haondt/Sailfish/pictures/20151111_104028.jpg

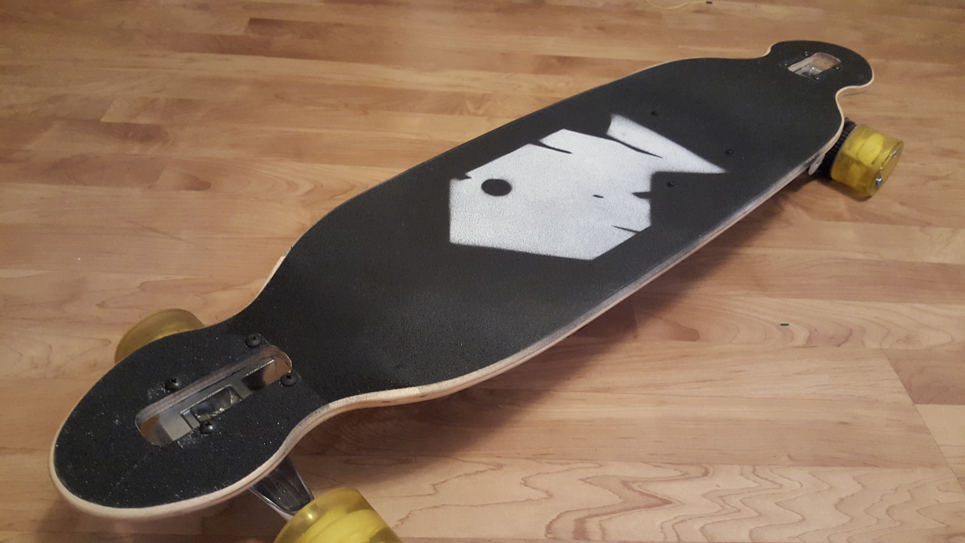
pictures/20151111_104028.jpg
