haondt/Sailfish/pictures/IMG_20160110_111257.jpg

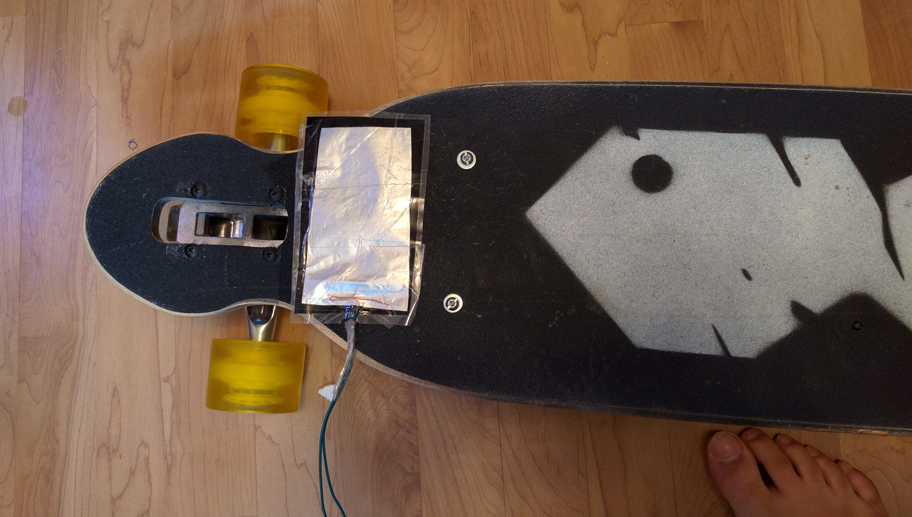
pictures/IMG_20160110_111257.jpg
