haondt/Sailfish/README.md

# Sailfish
A homemade electric longboard
https://www.youtube.com/watch?v=s4fFQhHfHzQ
Written in C/C++ for the Arduino.
Goes with accompanying code for the remote.
