haondt/Sailfish/pictures/20151111_104035.jpg

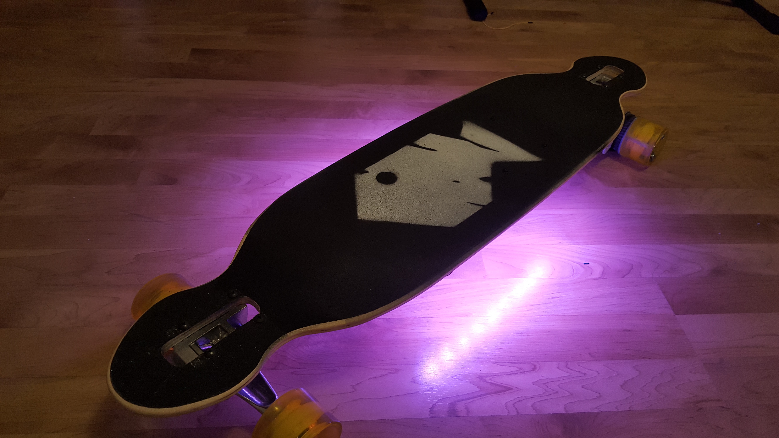
pictures/20151111_104035.jpg
