haondt/Sailfish/pictures/IMG_20160110_111248.jpg

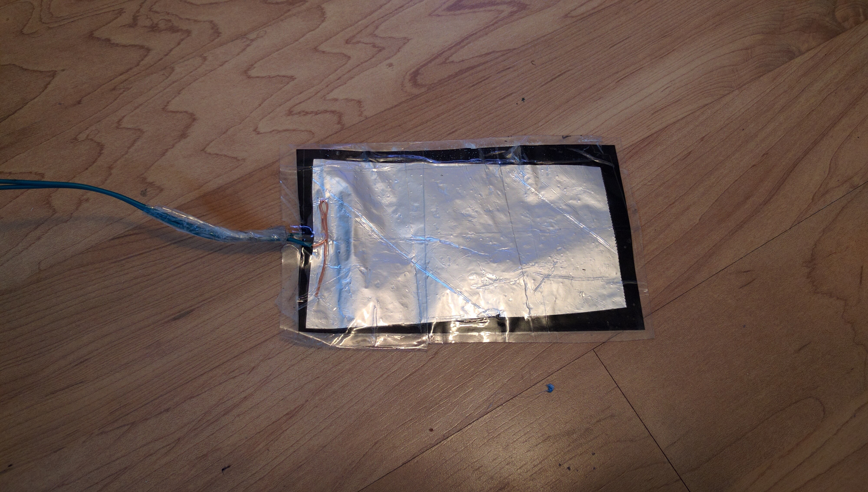
pictures/IMG_20160110_111248.jpg
