haondt/Sailfish/3d models/2.stl

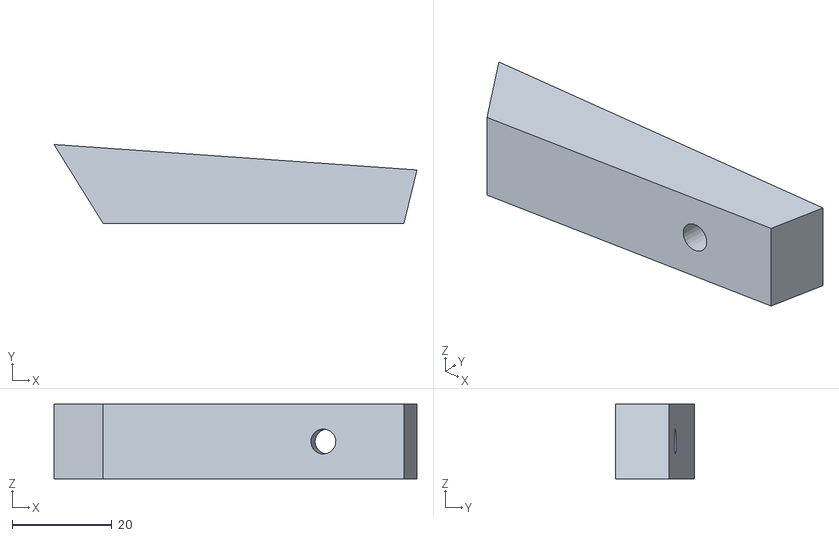
[picture p10: CAD file, 2018-02-10]
3d models/2.stl
72.8 x 15.9 x 15.0
