haondt/Sailfish/3d models/triangle.stl

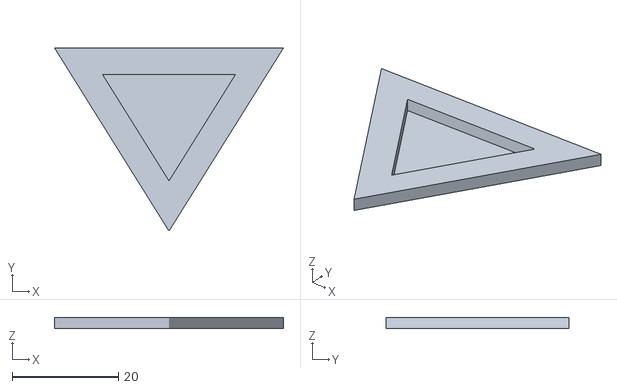
[picture p11: CAD file, 2018-02-10]
3d models/triangle.stl
43.0 x 34.4 x 2.00
