haondt/Sailfish/3d models/other models/zip tie spacer v1.stl

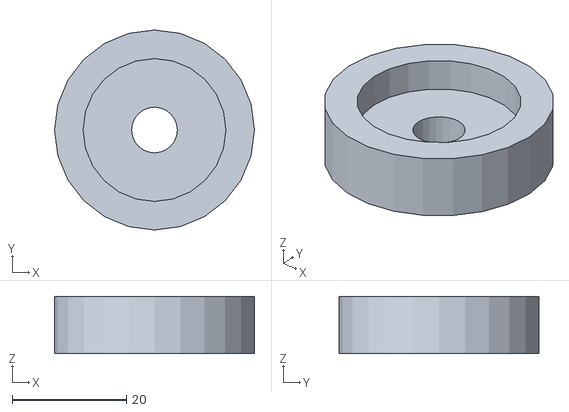
[picture p12: CAD file, 2018-02-10]
3d models/other models/zip tie spacer v1.stl
35.0 x 35.0 x 10.0
