haondt/Sailfish/3d models/other models/motor spacer v3.stl

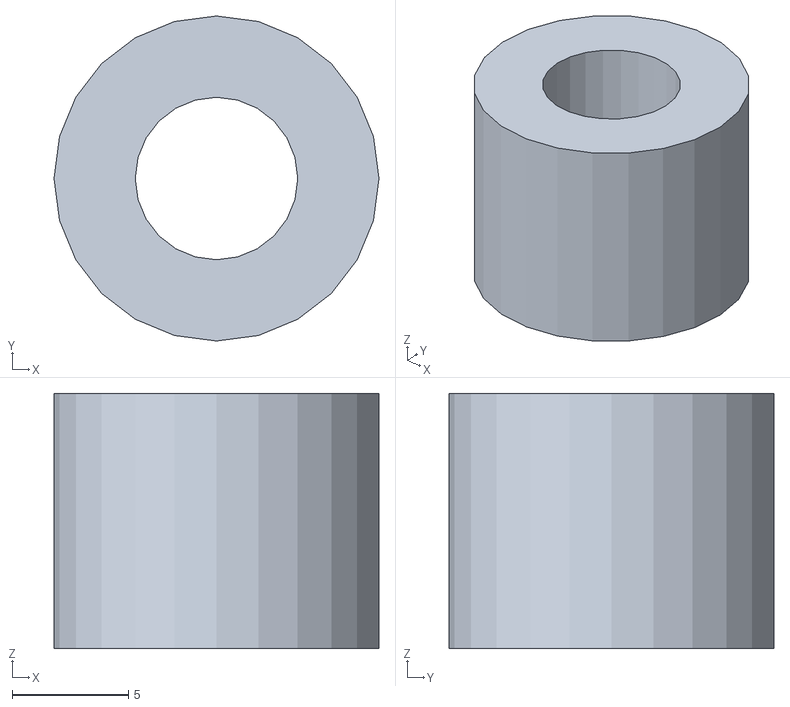
[picture p13: CAD file, 2018-02-10]
3d models/other models/motor spacer v3.stl
14.0 x 14.0 x 11.0
