haondt/Sailfish/3d models/other models/motor mount v7.stl

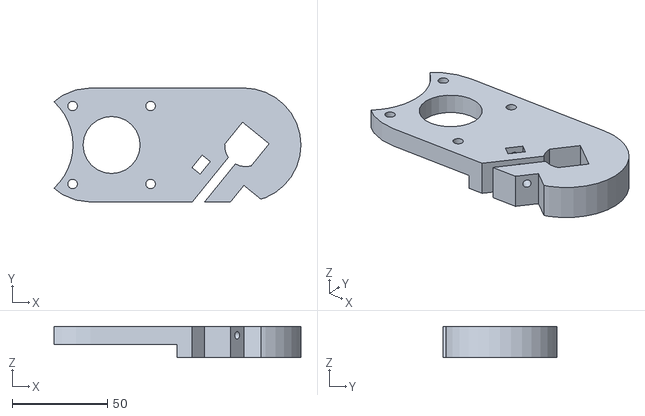
[picture p14: CAD file, 2018-02-10]
3d models/other models/motor mount v7.stl
129.9 x 60.0 x 16.5
