haondt/Sailfish/3d models/4.stl

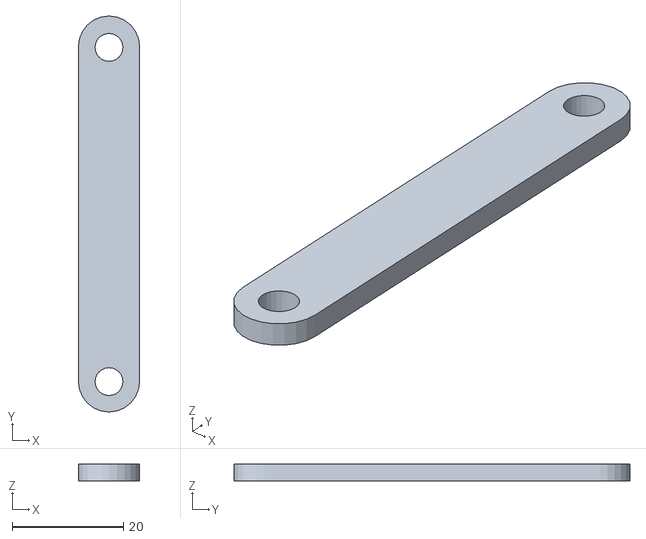
[picture p15: CAD file, 2018-02-10]
3d models/4.stl
11.0 x 71.1 x 3.00
