haondt/Sailfish/3d models/other models/motor spacer.stl

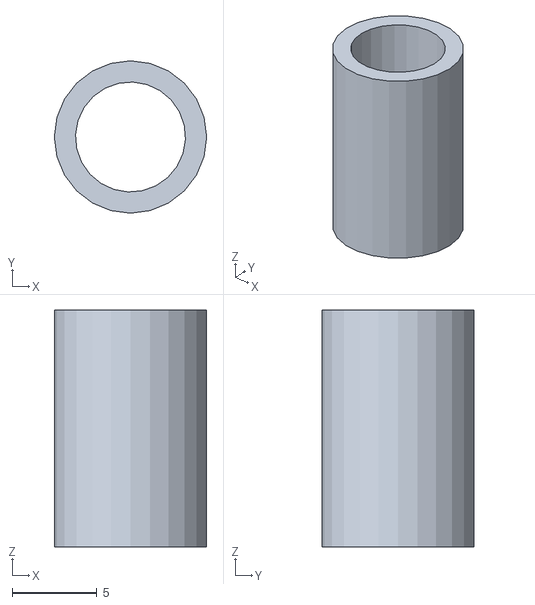
[picture p16: CAD file, 2018-02-10]
3d models/other models/motor spacer.stl
9.00 x 9.00 x 14.0
