haondt/Sailfish/3d models/thingc 2.stl

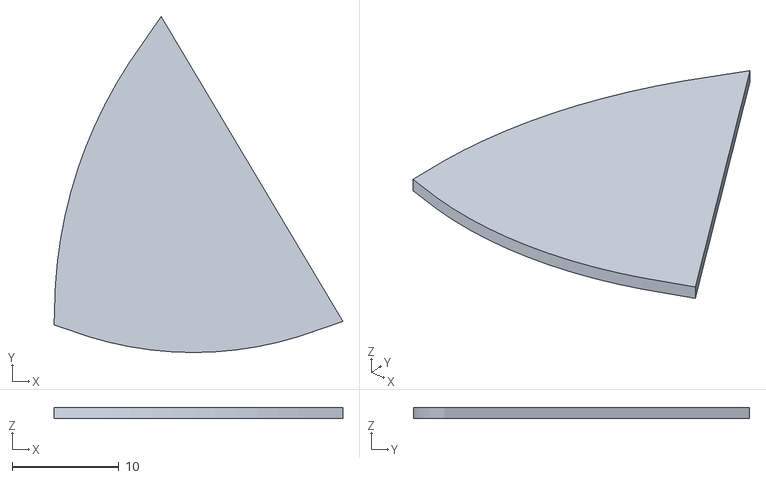
[picture p17: CAD file, 2018-02-10]
3d models/thingc 2.stl
27.0 x 31.4 x 1.00
