haondt/Sailfish/3d models/awkward motor mount.stl

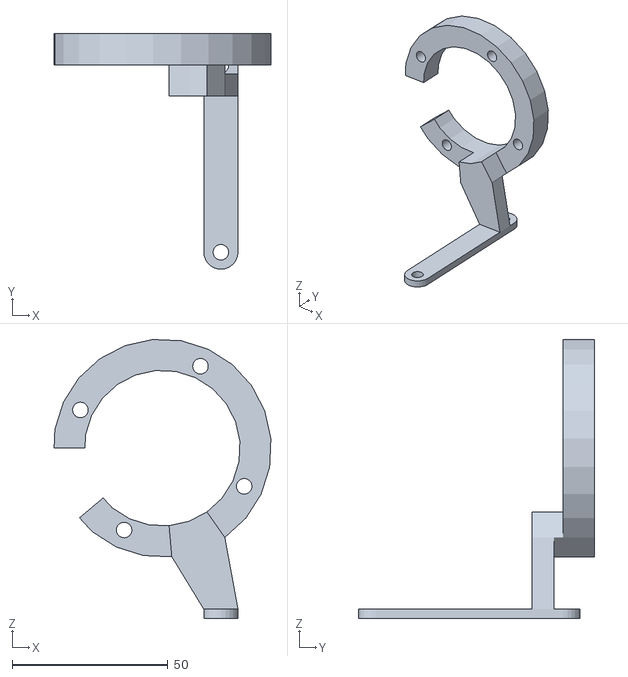
[picture p18: CAD file, 2018-02-10]
3d models/awkward motor mount.stl
69.6 x 75.6 x 89.5
