haondt/Sailfish/3d models/mototr mount v4.stl

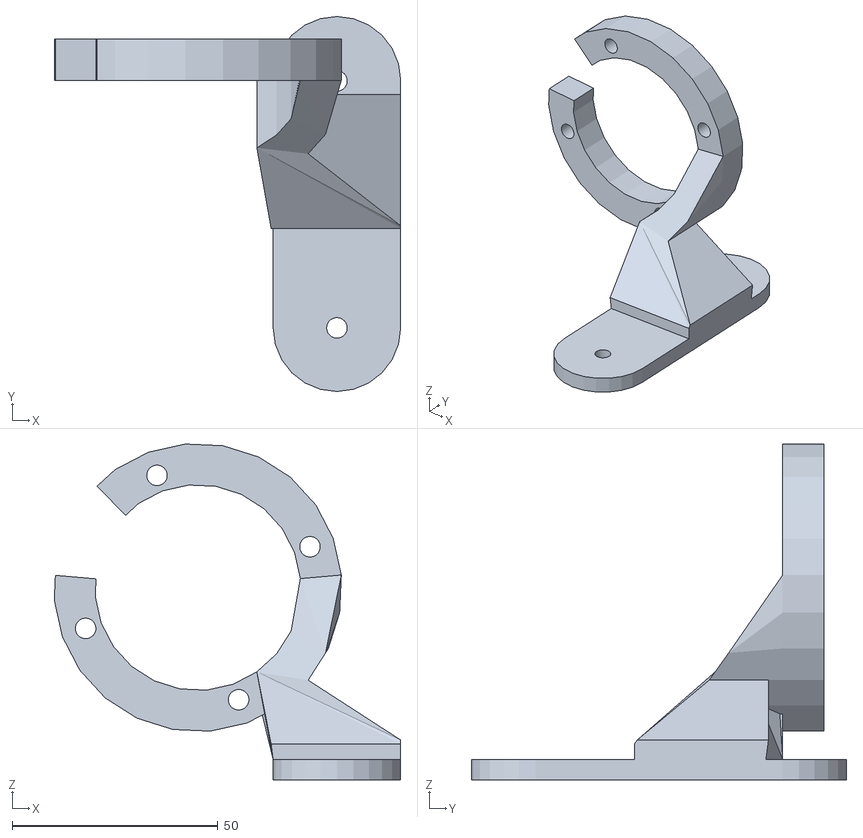
[picture p19: CAD file, 2018-02-10]
3d models/mototr mount v4.stl
84.2 x 91.1 x 81.6
