haondt/Sailfish/3d models/circle.stl

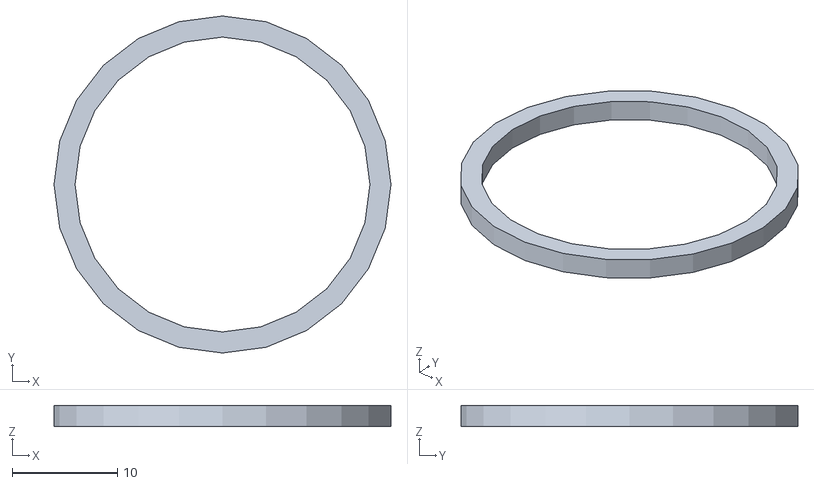
[picture p20: CAD file, 2018-02-10]
3d models/circle.stl
32.0 x 32.0 x 2.00
