haondt/Sailfish/3d models/motor mount v13_fixed.stl

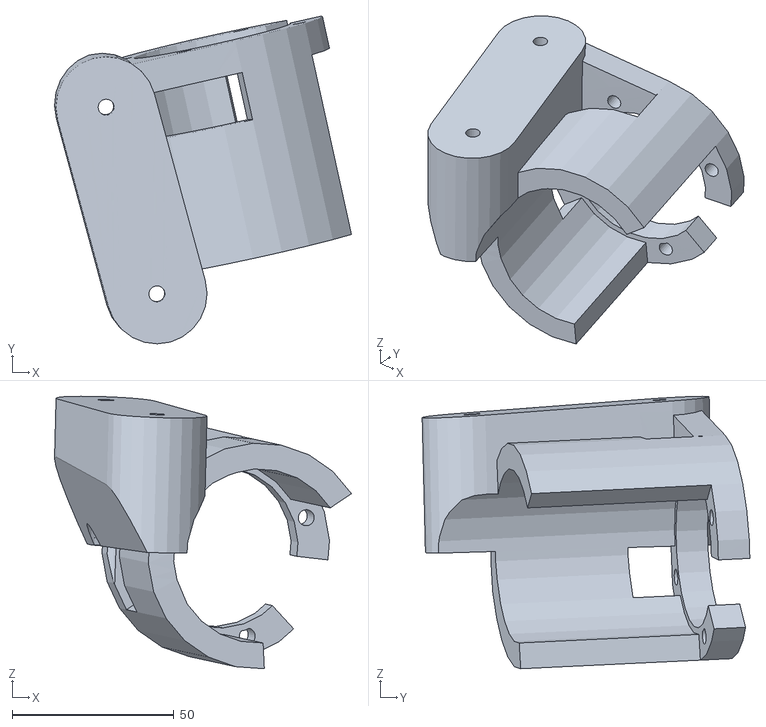
[picture p21: CAD file, 2018-02-10]
3d models/motor mount v13_fixed.stl
91.9 x 101.4 x 84.3
