haondt/Sailfish/3d models/thingy.stl

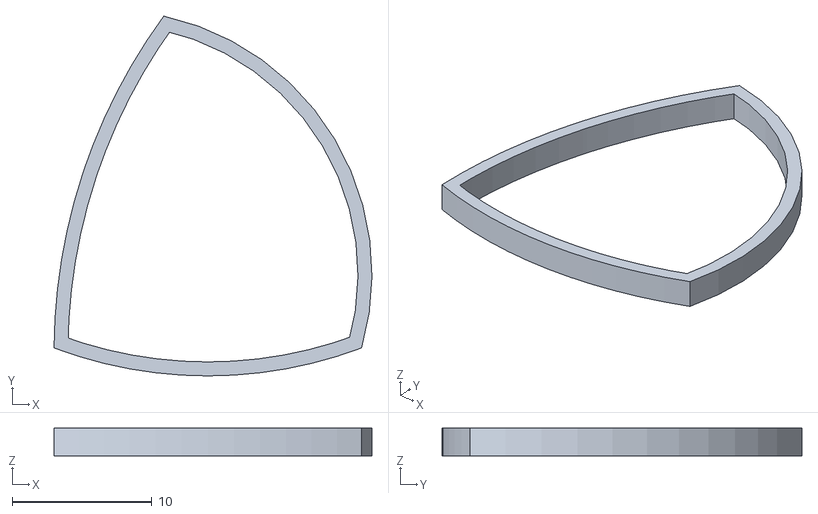
[picture p23: CAD file, 2018-02-10]
3d models/thingy.stl
22.7 x 25.7 x 2.00
