haondt/Sailfish/3d models/1.stl

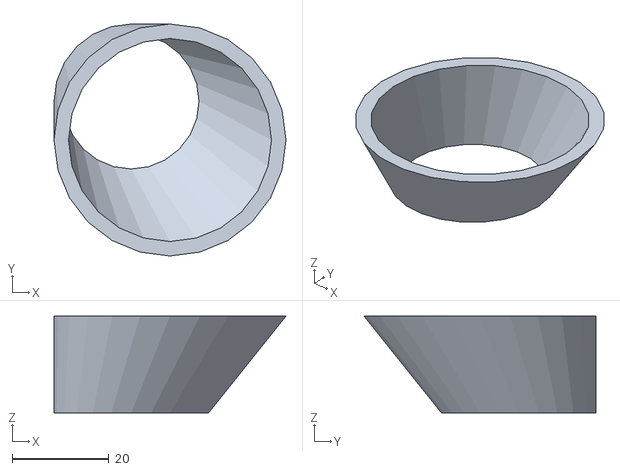
[picture p24: CAD file, 2018-02-10]
3d models/1.stl
48.0 x 48.0 x 20.0
