haondt/Sailfish/3d models/3.stl

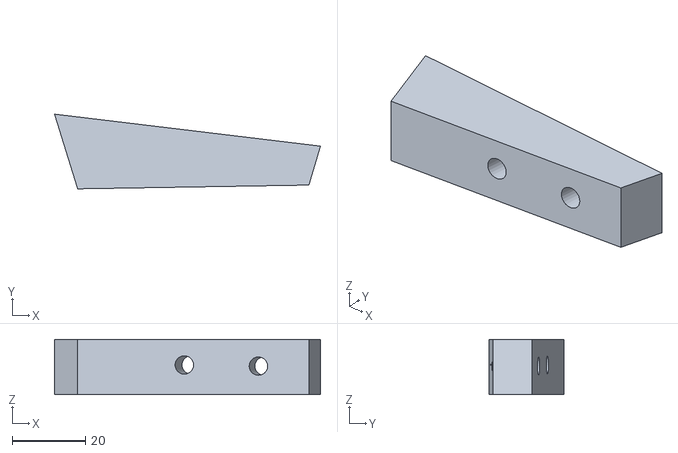
[picture p25: CAD file, 2018-02-10]
3d models/3.stl
72.5 x 20.4 x 15.0
