haondt/Sailfish/3d models/motor test mount a.stl

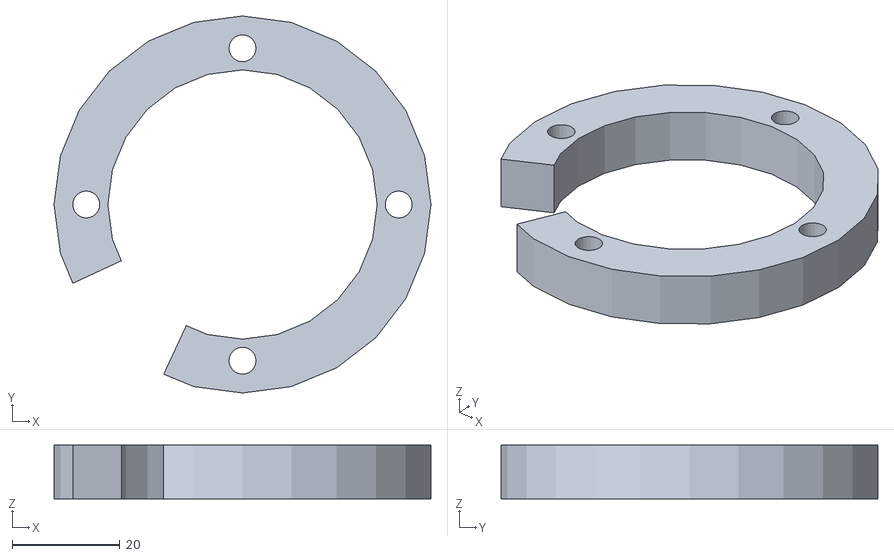
[picture p26: CAD file, 2018-02-10]
3d models/motor test mount a.stl
70.0 x 70.0 x 10.0
