haondt/Sailfish/(list of files, cad)

Other CAD files:
3d models/awkward motor mount_fixed.stl
3d models/Untitled-55f0d8fd.stl
3d models/motor mount file.skp
3d models/motor mount sketchup.skp
3d models/motor mount v1.stl
3d models/motor mount v10.stl
3d models/motor mount v10_fixed.stl
3d models/motor mount v11.stl
3d models/motor mount v11_fixed.stl
3d models/motor mount v12.stl
3d models/motor mount v12_fixed.stl
3d models/motor mount v2.stl
3d models/motor mount v2_fixed.stl
3d models/motor mount v3.stl
3d models/motor mount v3_fixed.stl
3d models/motor mount v4.stl
3d models/motor mount v4_fixed.stl
3d models/motor mount v5.stl
3d models/motor mount v5_fixed.stl
3d models/motor mount v6.stl
3d models/motor mount v6_fixed.stl
3d models/motor mount v7.stl
3d models/motor mount v7_fixed.stl
3d models/motor mount v8.stl
3d models/motor mount v9.stl
3d models/motor mount v9_fixed.stl
3d models/motor spacer v2.stl
3d models/other models/motor mount sketchup.skp
3d models/other models/motor mount v1.stl
3d models/other models/motor mount v2.stl
3d models/other models/motor mount v3.stl
3d models/other models/motor mount v4.stl
3d models/other models/motor mount v5.stl
3d models/other models/motor mount v6.stl
3d models/other models/motor spacer v2.stl
3d models/other models/zip tie spacer v1.skp
3d models/zip tie spacer v1.skp
