haondt/Sailfish/longboardv2/longboardv2.ino

#include <Servo.h> //Treating the esc as a servo
#include <SoftwareSerial.h> //Serial Port for bluetooth module

SoftwareSerial mySerial(3,2); //Connecting to the tx and rx pins of the bluetooth module
Servo esc; // creating the esc
int hall = 6; // hall effect sensor for measuring speed
int spd = 0; // "speed" value sent to esc
void setup(){
  esc.attach(5); // esc signal pin on pin 5
  esc.writeMicroseconds(700); //tell the esc the minimum value (equivalent of sending esc.write(0);)
  delay(2000); // wait for a beep from the esc
  esc.writeMicroseconds(2000); // the esc the maximum value (equivalent of sending esc.write(180);)
  delay(1000); // wait for beep from esc
  esc.writeMicroseconds(700); // return to lowest position
  // if this were an rc helicopter for example, this would be like bringing the throttle to max then back down again
  delay(2000); // wait to make sure esc is fully initialized 
  mySerial.begin(9600); // open serial connection with bluetooth module 
  pinMode(6,INPUT); // set the hall effect sensor as an input
  digitalWrite(6,HIGH); // activate the internal pullup resistor on pin 6
}

void loop(){
  esc.write(spd); // important to constantly tell the esc the current speed so it doesnt engage the safety shutoff
  delay(10); // avoids overloading the esc with too many commands to quickly
  if(spd>=20 ){ // so long as the is going over speed 20, i.e moving at a reasonable pace,
    if(!digitalRead(6)){ //this is to check the speed of the board, and is optional
      long i = millis();
      while(!digitalRead(6)){}
      while(digitalRead(6)){}
      double j = millis()-i;
      double k = 220/j;
      double l = k*3.6;
      int m = l;
      mySerial.write(m); // send the speed over serial
    }
  }
  
  if (mySerial.available()){ // when we receive information over serial
    
    char i = mySerial.read(); //find out which letter the serial sends (A= faster, B= slower, C= stop)
    if(i=='A'){ // "faster"
      if(spd>=20 && spd<=130){ // if the board is over speed twenty, and below the max speed, i.e board is already moving,
        spd+=10; //accelerate
        esc.write(spd);
        delay(100); // give board time to accelerate
      }
      else if(spd<=19){ //if speed is below 20, i.e board is either stopped or barely going fast enough to move under load
        spd=20; // speed all the way up to twenty
        esc.write(spd);
        delay(3000); // give suffiecient time to reach speed from standstill
      }
    }
    else if(i=='B'){ // "slow down" 
      if(spd>=30){ // if board is going over thirty, i.e 10+ above minimum speed
        spd-=10; // slow down by 10
        esc.write(spd);
        delay(100); // give time for decceleration
      }
      else if(spd>=20){ // if board is going speed 20-29
        for(int i=20;i-=1;i>=0){ // gradually slow down to a stop (the "slow stop")
          spd=i;
          esc.write(spd);
          delay(50); // can be adjusted for quicker stop
        }
        spd = 0;
        esc.write(spd);
      }
      else{ // if the board is going speed 19 or below, i.e some speed less than minimum speed, which it shouldn't, stop
        spd=0;
        esc.write(0);
      }
    }
    else if(i=='C'){ // emergency stop/deadman switch
      for(int i=spd;i-=1;i>=0){ // gradual slow down to a stop (the "fast stop")
        spd=i;
        esc.write(spd);
        delay(25); // can be adjusted for a quicker stop
      }
    }
  }
}
